asturkmani/STU/(list of files, cad)

Other CAD files:
Archives/Arduino-SVM-master/libsvm-3.20/tools/gnuplot-5.0.0/docs/windows/wgnuplot.stp
