asturkmani/STU/(list of files, drawings)

Other design files:
Circuit Schematic /461P.DSN
Circuit Schematic /461P.opj
