asturkmani/STU/IR setup.png

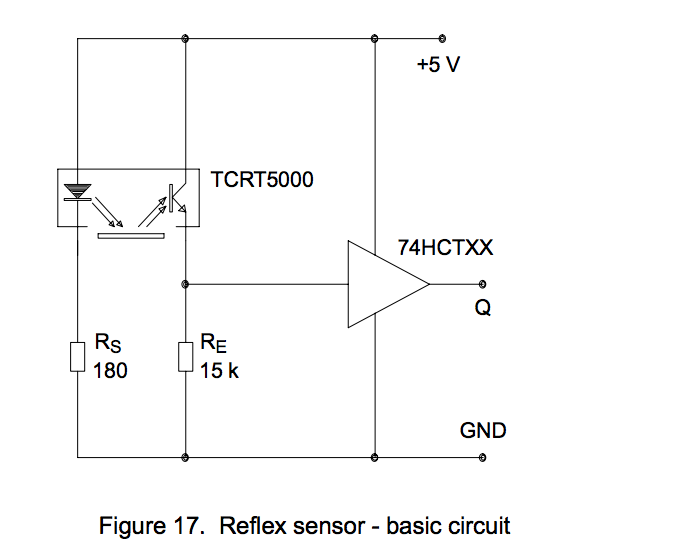
IR setup.png
