asturkmani/STU/Archives/Arduino-SVM-master/TestingCombined.txt

-1 1:25 2:49 3:41 4:27 5:0 6:25 7:30 8:8 9:0 10:0 11:27 12:19 13:16 14:8 15:32 16:33 17:19 18:0 19:27 20:35 21:19 22:8 23:0 24:0 25:0 26:0 27:0 28:0 29:8 30:0 31:0 32:8 ;
-1 1:77 2:72 3:35 4:30 5:8 6:37 7:35 8:19 9:19 10:30 11:16 12:0 13:25 14:35 15:33 16:0 17:25 18:38 19:44 20:56 21:48 22:33 23:8 24:19 25:0 26:16 27:25 28:0 29:19 30:0 31:8 32:0 ;
-1 1:75 2:68 3:16 4:30 5:0 6:37 7:37 8:19 9:30 10:0 11:24 12:30 13:33 14:41 15:51 16:39 17:0 18:27 19:41 20:60 21:57 22:39 23:43 24:33 25:27 26:30 27:24 28:8 29:0 30:33 31:0 32:30 ;
-1 1:71 2:64 3:16 4:24 5:32 6:19 7:27 8:25 9:8 10:19 11:8 12:19 13:24 14:41 15:35 16:33 17:0 18:16 19:25 20:8 21:0 22:0 23:19 24:0 25:19 26:8 27:8 28:0 29:19 30:0 31:8 32:0 ;
-1 1:45 2:48 3:30 4:33 5:0 6:27 7:24 8:25 9:0 10:0 11:8 12:0 13:24 14:30 15:0 16:30 17:0 18:8 19:8 20:19 21:19 22:0 23:24 24:0 25:0 26:8 27:0 28:0 29:0 30:8 31:8 32:8 ;
-1 1:41 2:44 3:30 4:35 5:0 6:19 7:33 8:19 9:0 10:0 11:16 12:8 13:0 14:8 15:8 16:19 17:0 18:0 19:0 20:0 21:0 22:16 23:16 24:0 25:0 26:0 27:8 28:0 29:0 30:0 31:0 32:8 ;
-1 1:32 2:41 3:30 4:30 5:19 6:27 7:19 8:25 9:0 10:19 11:0 12:0 13:19 14:19 15:0 16:19 17:0 18:0 19:0 20:24 21:30 22:0 23:0 24:0 25:0 26:8 27:0 28:0 29:19 30:8 31:0 32:0 ;
-1 1:32 2:46 3:30 4:27 5:19 6:19 7:27 8:24 9:0 10:8 11:19 12:0 13:8 14:8 15:25 16:0 17:0 18:16 19:8 20:30 21:0 22:19 23:16 24:19 25:0 26:8 27:8 28:8 29:8 30:8 31:8 32:8 ;
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
1 1:77 2:73 3:32 4:47 5:30 6:38 7:46 8:27 9:19 10:27 11:8 12:39 13:19 14:39 15:19 16:16 17:35 18:35 19:51 20:54 21:30 22:30 23:0 24:19 25:16 26:19 27:16 28:0 29:8 30:0 31:16 32:19 ;
