asturkmani/STU/Archives/Arduino-SVM-master/libsvm-3.20/java/testGlass.txt

84 80 51 39 43 16 33 38 41 46 25 0 24 19 19 35 35 61 72 72 50 37 32 19 24 19 16 30 27 30 8 16 ;
51 50 30 30 32 24 24 33 0 19 8 19 19 30 46 19 0 0 0 8 30 0 0 0 0 8 0 8 0 0 8 0 ;
83 79 46 24 43 30 19 47 33 40 8 35 0 27 30 8 38 61 73 70 53 33 16 16 8 0 8 27 19 25 0 0 ;
73 61 37 46 33 43 19 35 8 19 0 19 24 46 50 35 8 16 19 48 43 0 0 16 16 0 8 16 0 8 8 8 ;
57 56 47 19 32 19 30 16 0 8 8 27 27 16 25 47 35 27 39 41 24 0 0 24 0 16 19 19 0 19 8 0 ;
79 70 41 35 19 27 33 33 19 19 37 16 19 43 8 19 51 30 61 59 55 38 27 27 8 19 16 0 8 0 19 8 ;
67 58 43 19 35 30 16 30 0 33 19 30 30 32 19 30 24 38 42 45 39 32 32 25 0 27 27 8 24 0 19 0 ;
78 67 30 30 41 16 16 8 0 19 19 27 16 19 19 8 0 0 16 37 35 0 8 0 0 8 8 8 0 0 19 0 ;
59 54 30 25 27 27 25 27 8 24 24 0 0 16 16 33 19 35 8 33 40 25 0 8 19 0 8 8 0 0 8 8 ;
64 59 35 30 19 35 27 19 0 8 0 19 8 8 30 19 0 0 0 25 0 0 8 0 0 8 8 19 8 0 8 0 ;
67 58 35 38 0 30 27 27 0 8 0 19 8 24 42 30 0 0 0 24 16 0 8 0 0 0 8 0 0 0 8 0 ;
81 70 43 19 30 8 33 25 0 33 35 24 33 25 40 0 25 48 65 71 44 16 16 16 8 0 24 19 24 0 0 19 ;
77 73 32 47 30 38 46 27 19 27 8 39 19 39 19 16 35 35 51 54 30 30 0 19 16 19 16 0 8 0 16 19 ;
