asturkmani/STU/Archives/Arduino-SVM-master/libsvm-3.20/java/testNotGlass.txt

25 49 41 27 0 25 30 8 0 0 27 19 16 8 32 33 19 0 27 35 19 8 0 0 0 0 0 0 8 0 0 8 ;
77 72 35 30 8 37 35 19 19 30 16 0 25 35 33 0 25 38 44 56 48 33 8 19 0 16 25 0 19 0 8 0 ;
75 68 16 30 0 37 37 19 30 0 24 30 33 41 51 39 0 27 41 60 57 39 43 33 27 30 24 8 0 33 0 30 ;
71 64 16 24 32 19 27 25 8 19 8 19 24 41 35 33 0 16 25 8 0 0 19 0 19 8 8 0 19 0 8 0 ;
45 48 30 33 0 27 24 25 0 0 8 0 24 30 0 30 0 8 8 19 19 0 24 0 0 8 0 0 0 8 8 8 ;
41 44 30 35 0 19 33 19 0 0 16 8 0 8 8 19 0 0 0 0 0 16 16 0 0 0 8 0 0 0 0 8 ;
32 41 30 30 19 27 19 25 0 19 0 0 19 19 0 19 0 0 0 24 30 0 0 0 0 8 0 0 19 8 0 0 ;
32 46 30 27 19 19 27 24 0 8 19 0 8 8 25 0 0 16 8 30 0 19 16 19 0 8 8 8 8 8 8 8 ;
25 40 24 27 0 19 24 27 8 0 8 0 0 24 19 24 0 0 16 19 0 0 19 0 0 8 19 0 0 0 8 8 ;
16 37 30 30 19 27 27 19 0 24 19 0 0 19 16 19 0 0 16 0 0 27 0 8 0 0 0 8 0 19 8 8 ;
65 67 33 44 8 43 0 39 0 30 8 24 16 19 27 27 19 42 37 47 38 33 16 27 8 19 0 16 0 19 16 0 ;
69 61 35 19 37 16 24 27 16 27 19 24 19 19 30 25 0 16 25 0 30 0 0 19 8 8 8 8 19 0 0 0 ;
51 49 30 33 0 35 25 33 0 19 19 8 19 19 0 25 0 27 0 40 33 30 0 8 8 0 19 0 0 8 8 8 ;
37 44 19 30 8 19 27 30 0 0 0 19 8 0 19 16 0 8 0 0 19 19 8 0 0 8 0 8 19 19 8 8 ;
32 46 19 27 24 30 8 27 0 19 0 19 16 24 0 24 0 0 8 19 8 19 0 8 0 8 0 8 8 8 0 8 ;
76 67 44 19 33 8 30 43 19 16 30 27 37 33 32 35 35 46 55 55 51 50 39 0 8 25 19 0 16 27 8 19 ;
74 69 35 51 0 33 16 33 19 33 16 33 0 33 19 19 27 41 58 65 54 30 24 19 0 27 25 19 16 8 16 16 ;
