asturkmani/STU/(commit log)

2015-04-12 Updated infrared sensor frequency
2015-04-19 included new sensor functions
2015-04-21 gave up on FFT + SVM
    [gnuplot.cfg, makefile.g, wgnuplot.stp]
2015-05-05 included circuit schematic, documentation and final code
    [461P.DSN, 461P.opj, gnuplot.cfg, makefile.g, wgnuplot.stp]
2015-05-08 complete project after submission
    [461P.DSN, 461P.opj]
2015-05-08 included circuit schematic
    [461P.DSN, 461P.opj]
